andrew-abdelmalak/smart-cleaning-robot/docs/figures/chassis_cad.jpeg

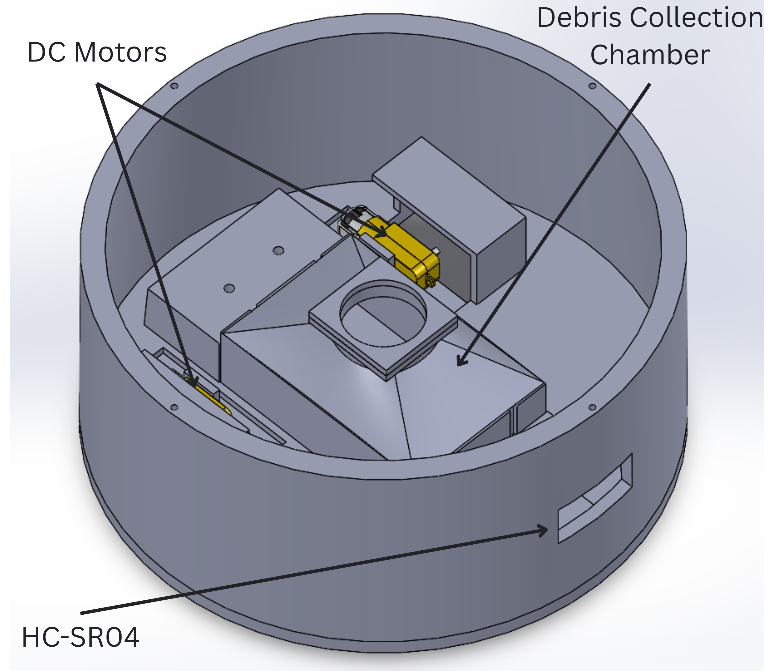
docs/figures/chassis_cad.jpeg
