andrew-abdelmalak/smart-cleaning-robot/docs/figures/figure_01.png

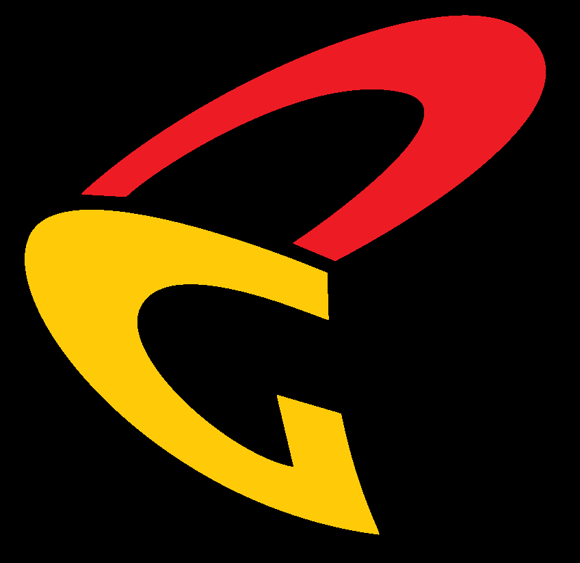
docs/figures/figure_01.png
