andrew-abdelmalak/smart-cleaning-robot/docs/figures/figure_02.jpeg

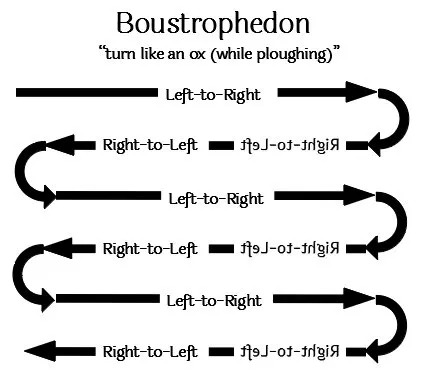
docs/figures/figure_02.jpeg
