andrew-abdelmalak/smart-cleaning-robot/docs/figures/figure_03.png

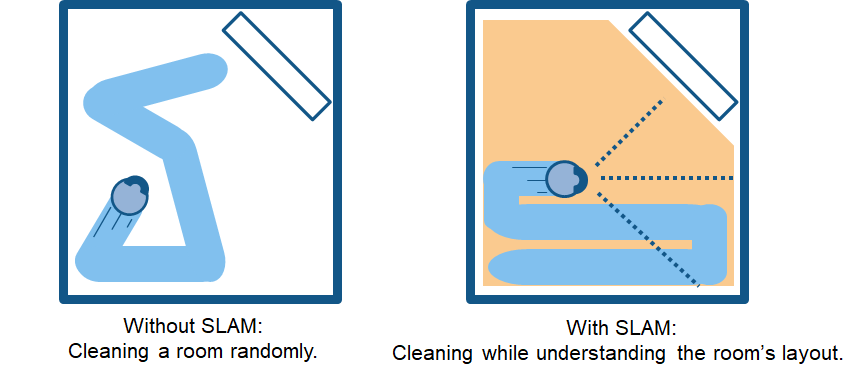
docs/figures/figure_03.png
