andrew-abdelmalak/smart-cleaning-robot/docs/figures/figure_04.jpeg

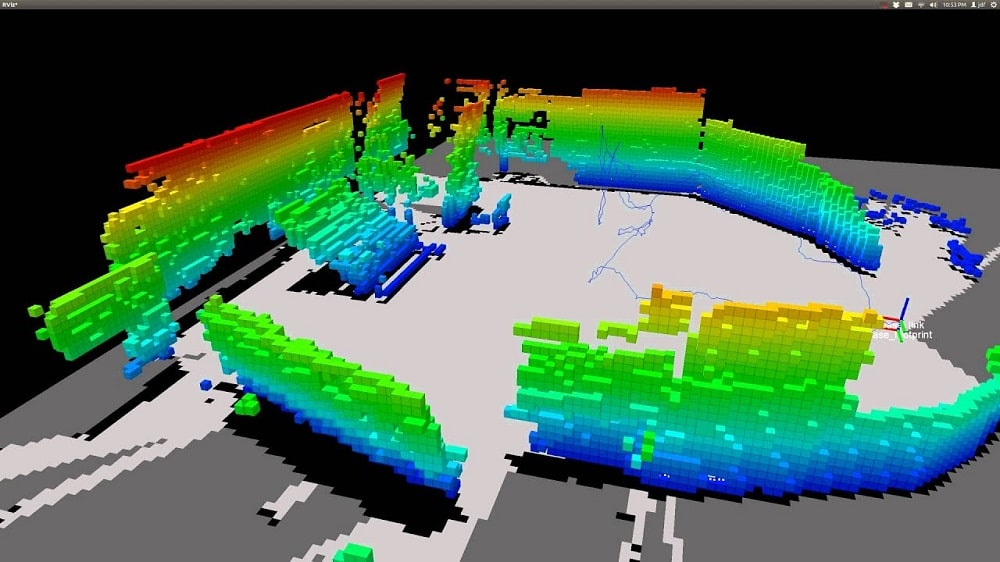
docs/figures/figure_04.jpeg
