andrew-abdelmalak/smart-cleaning-robot/docs/figures/figure_05.png

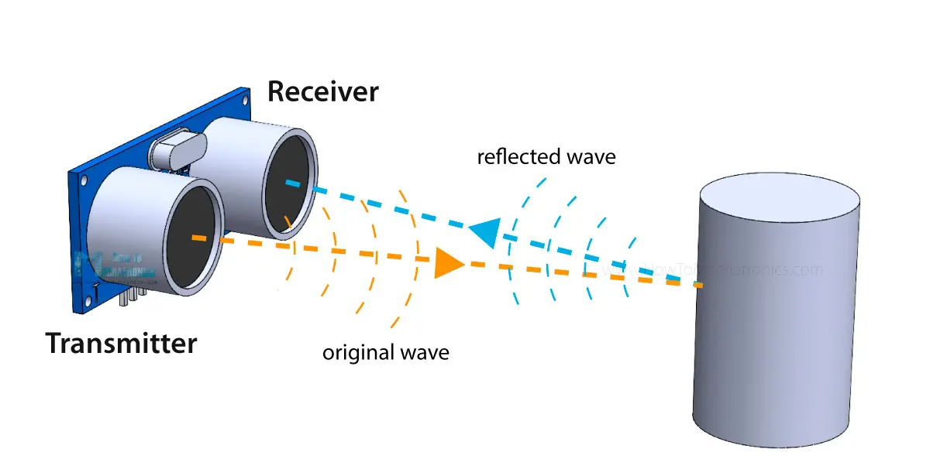
docs/figures/figure_05.png
