andrew-abdelmalak/smart-cleaning-robot/docs/figures/figure_07.jpeg

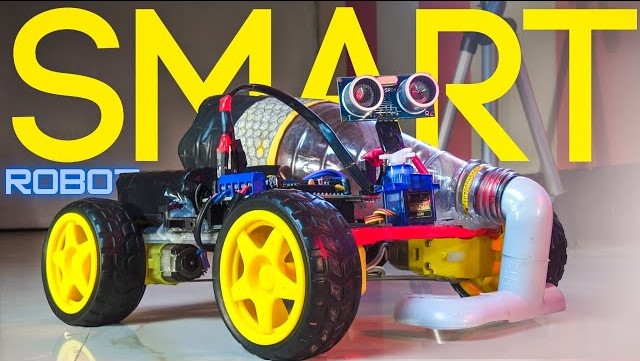
docs/figures/figure_07.jpeg
