andrew-abdelmalak/smart-cleaning-robot/docs/figures/figure_14.jpeg

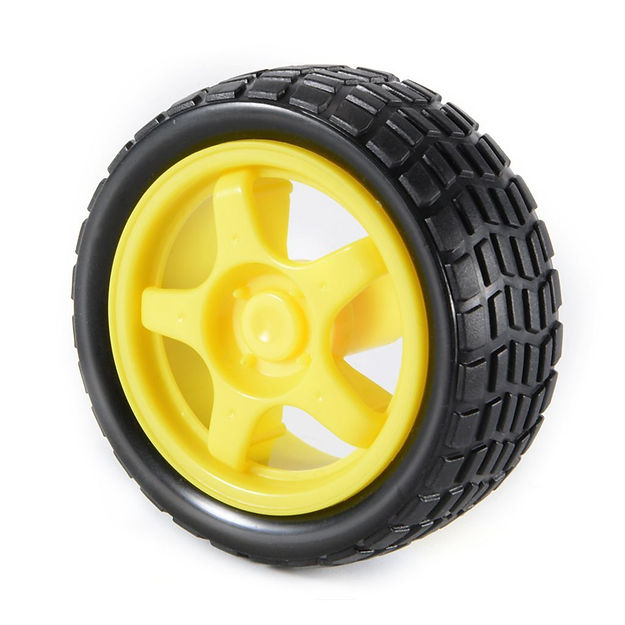
docs/figures/figure_14.jpeg
