andrew-abdelmalak/smart-cleaning-robot/docs/figures/figure_15.jpeg

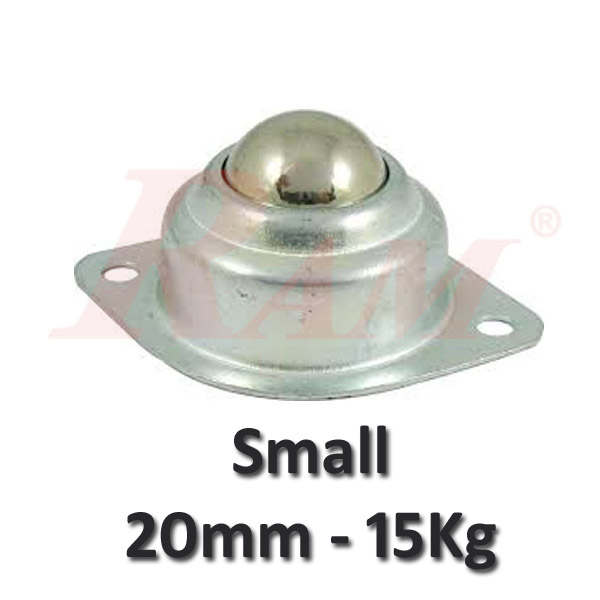
docs/figures/figure_15.jpeg
