andrew-abdelmalak/smart-cleaning-robot/docs/figures/figure_16.jpeg

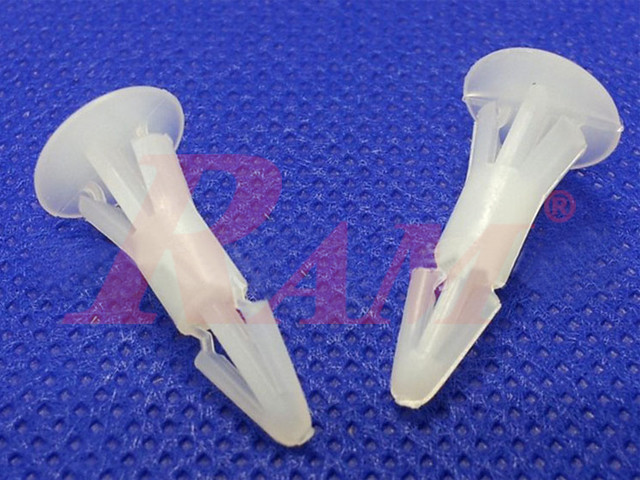
docs/figures/figure_16.jpeg
