andrew-abdelmalak/smart-cleaning-robot/docs/figures/figure_17.jpeg

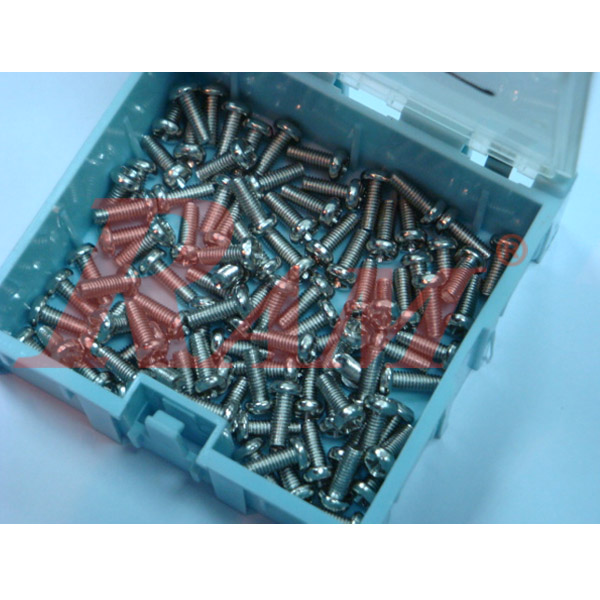
docs/figures/figure_17.jpeg
