andrew-abdelmalak/smart-cleaning-robot/docs/figures/figure_19.jpeg

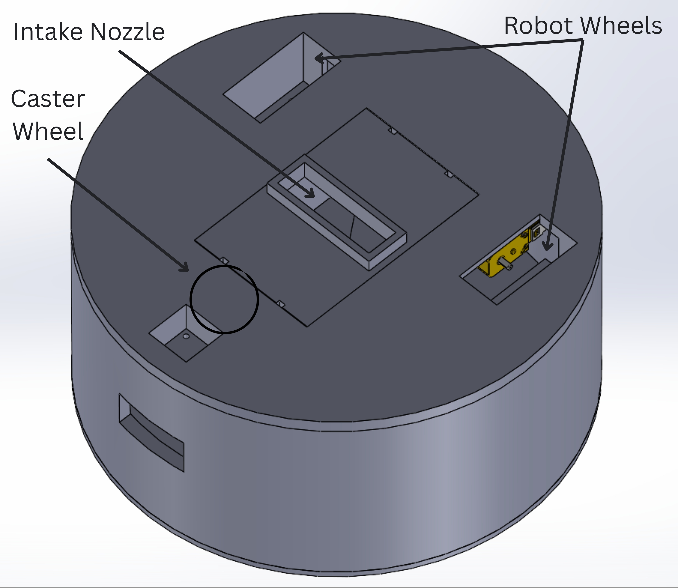
docs/figures/figure_19.jpeg
