andrew-abdelmalak/smart-cleaning-robot/docs/figures/figure_20.png

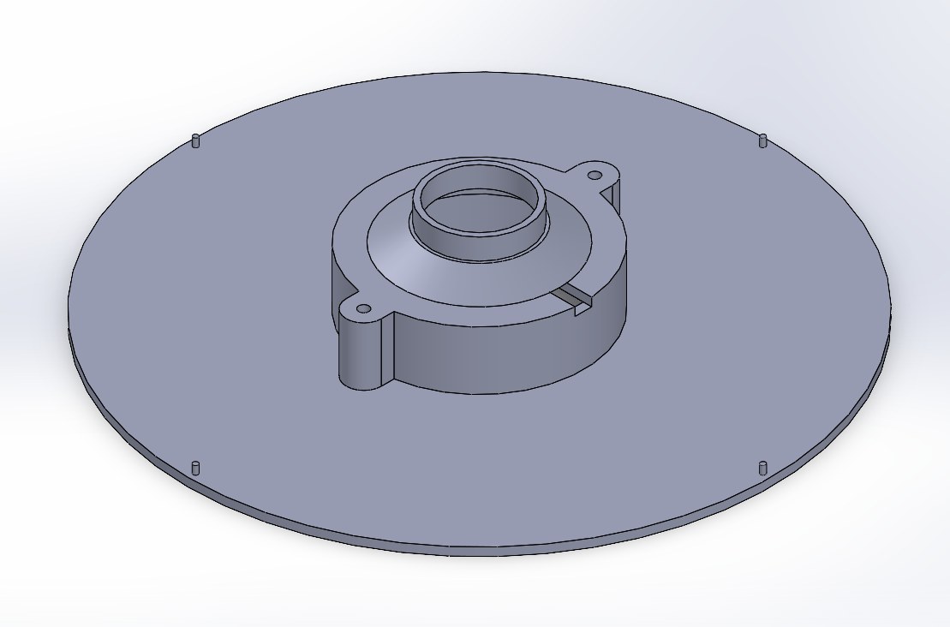
docs/figures/figure_20.png
