andrew-abdelmalak/smart-cleaning-robot/docs/figures/figure_25.jpeg

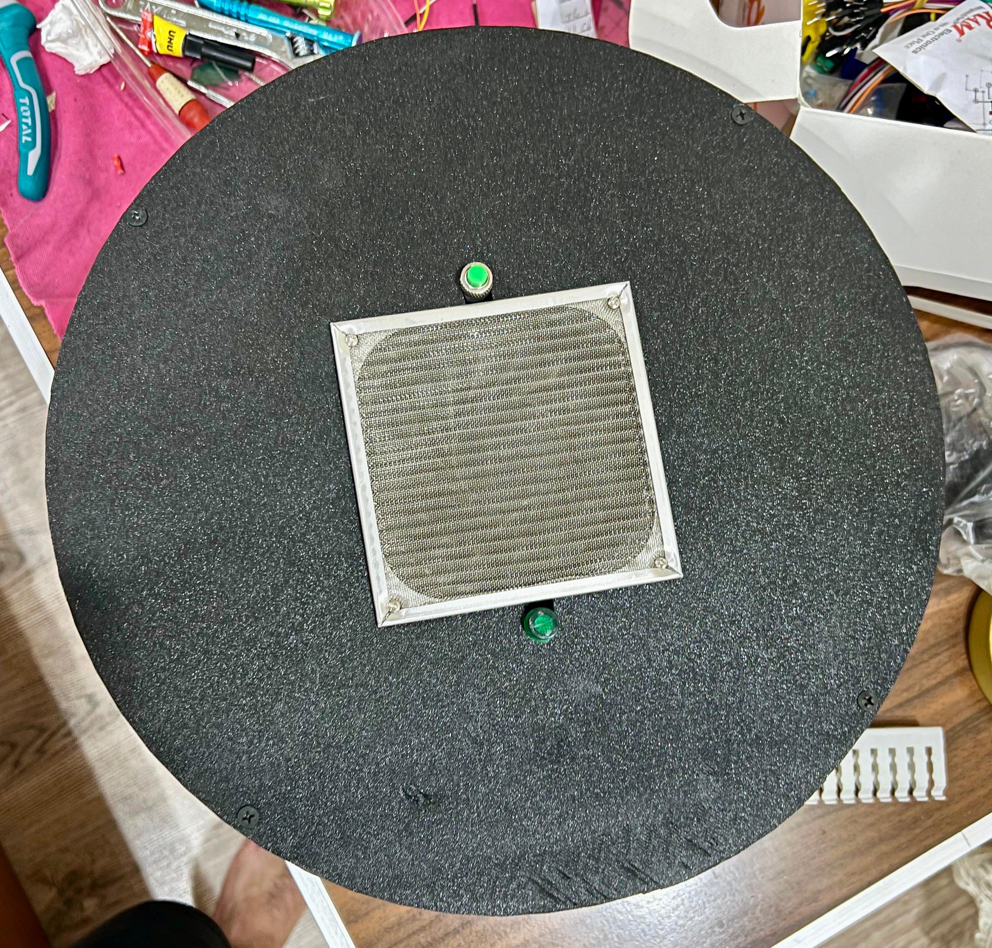
docs/figures/figure_25.jpeg
