andrew-abdelmalak/smart-cleaning-robot/docs/figures/figure_27.jpeg

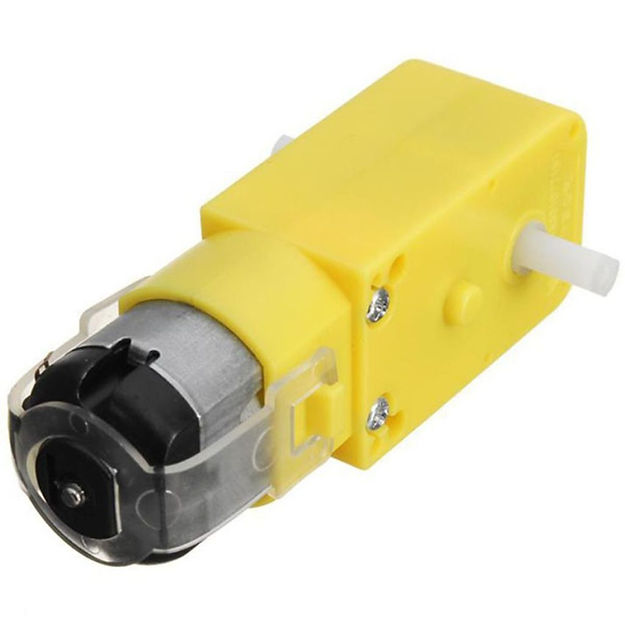
docs/figures/figure_27.jpeg
