andrew-abdelmalak/smart-cleaning-robot/docs/figures/figure_28.jpeg

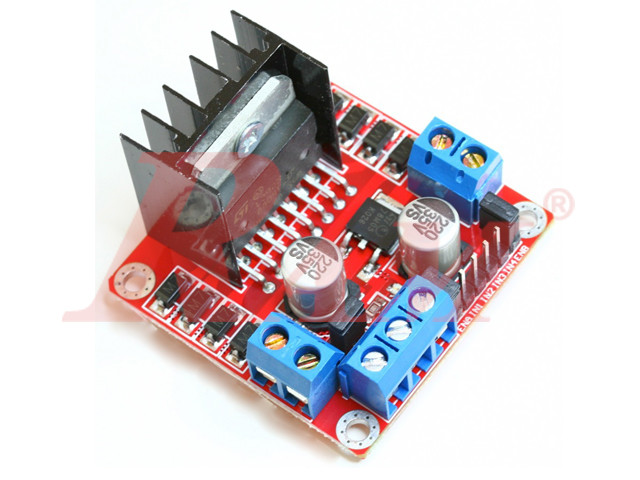
docs/figures/figure_28.jpeg
