andrew-abdelmalak/smart-cleaning-robot/docs/figures/figure_29.jpeg

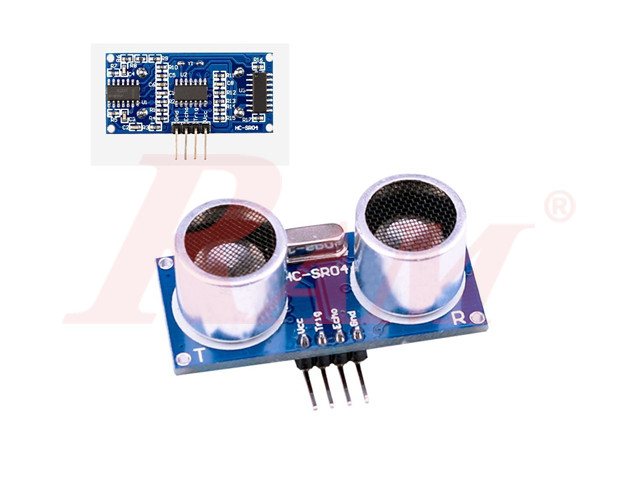
docs/figures/figure_29.jpeg
