andrew-abdelmalak/smart-cleaning-robot/docs/figures/figure_33.jpeg

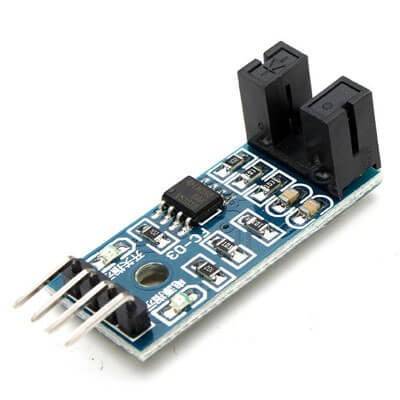
docs/figures/figure_33.jpeg
