andrew-abdelmalak/smart-cleaning-robot/docs/figures/figure_34.jpeg

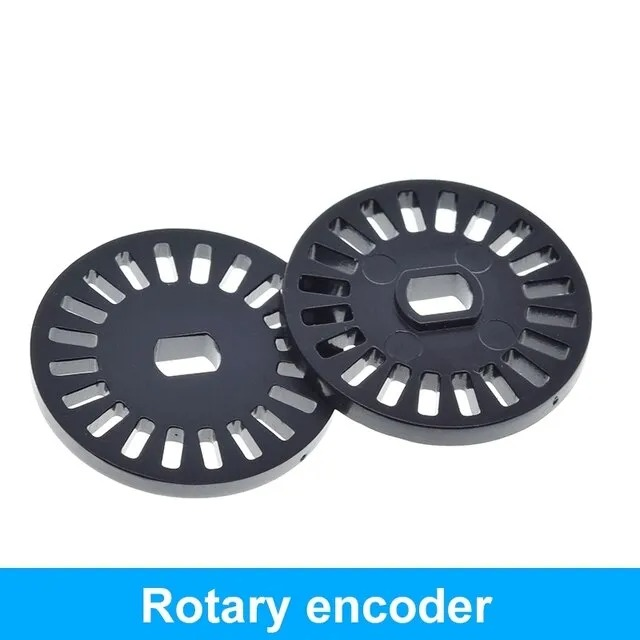
docs/figures/figure_34.jpeg
