andrew-abdelmalak/smart-cleaning-robot/docs/figures/figure_35.jpeg

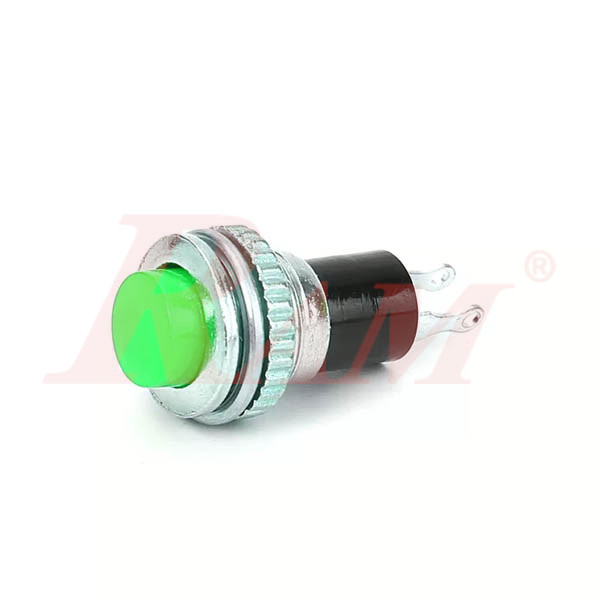
docs/figures/figure_35.jpeg
