andrew-abdelmalak/smart-cleaning-robot/docs/figures/figure_38.jpeg

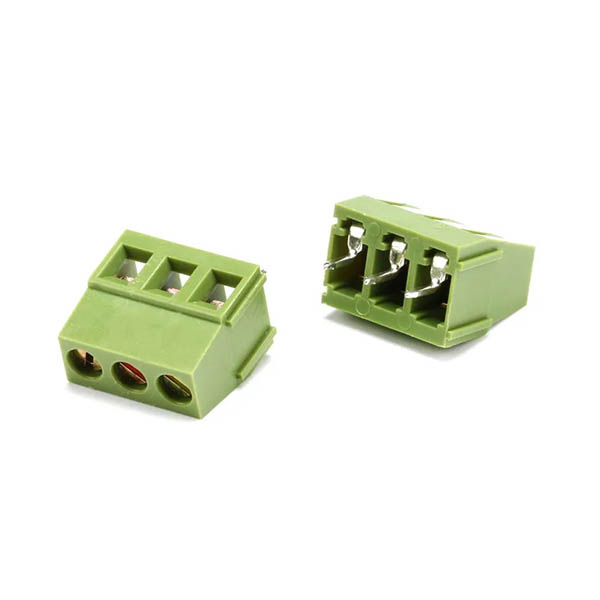
docs/figures/figure_38.jpeg
