andrew-abdelmalak/smart-cleaning-robot/docs/figures/figure_40.jpeg

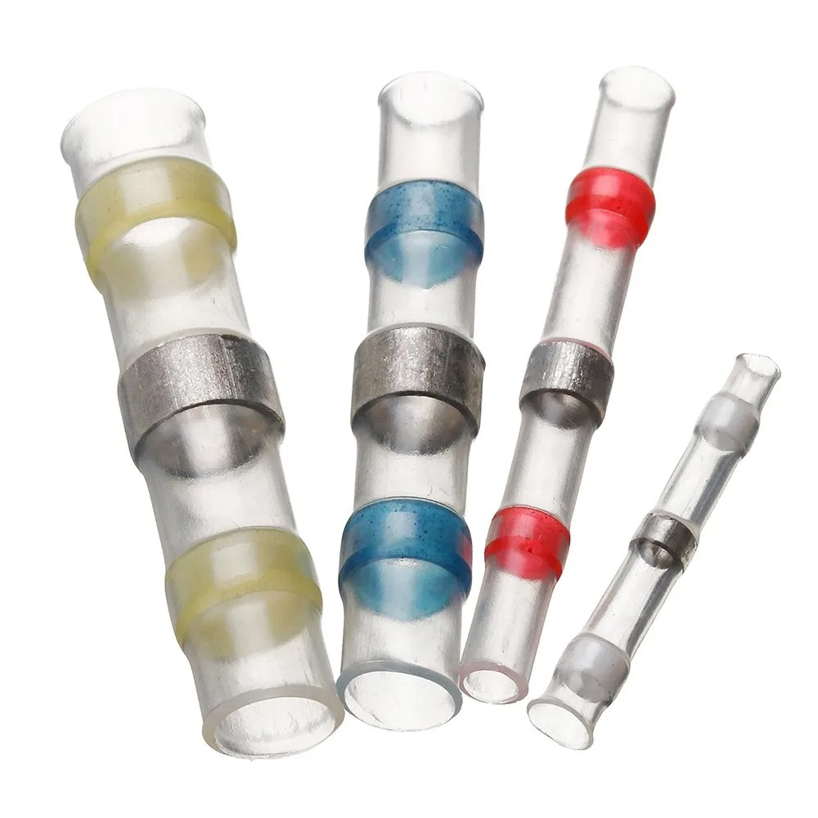
docs/figures/figure_40.jpeg
