andrew-abdelmalak/smart-cleaning-robot/docs/figures/figure_41.png

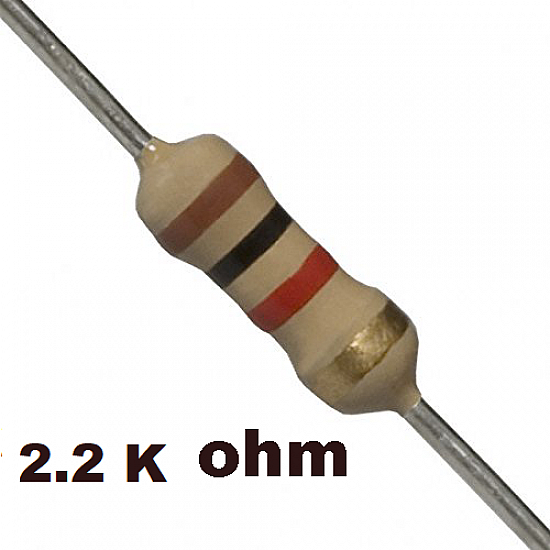
docs/figures/figure_41.png
