andrew-abdelmalak/smart-cleaning-robot/docs/figures/figure_43.jpeg

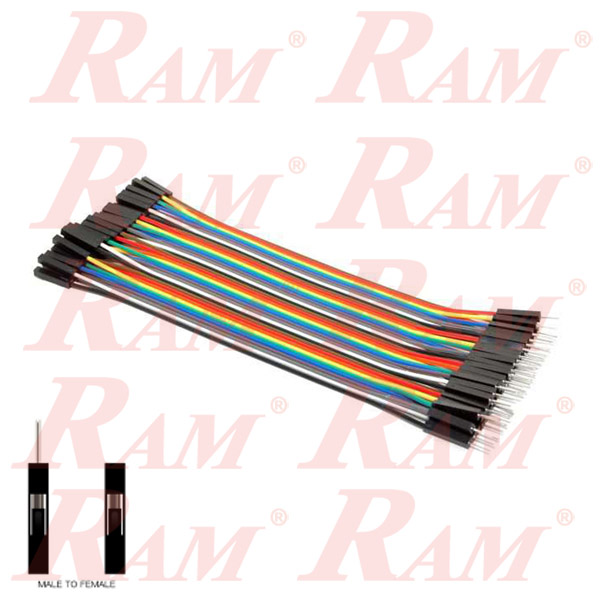
docs/figures/figure_43.jpeg
