andrew-abdelmalak/smart-cleaning-robot/docs/figures/figure_44.jpeg

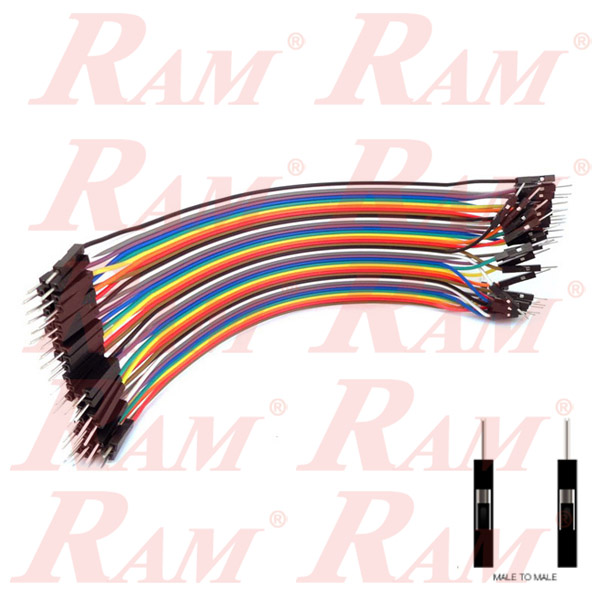
docs/figures/figure_44.jpeg
