andrew-abdelmalak/smart-cleaning-robot/docs/figures/figure_46.jpeg

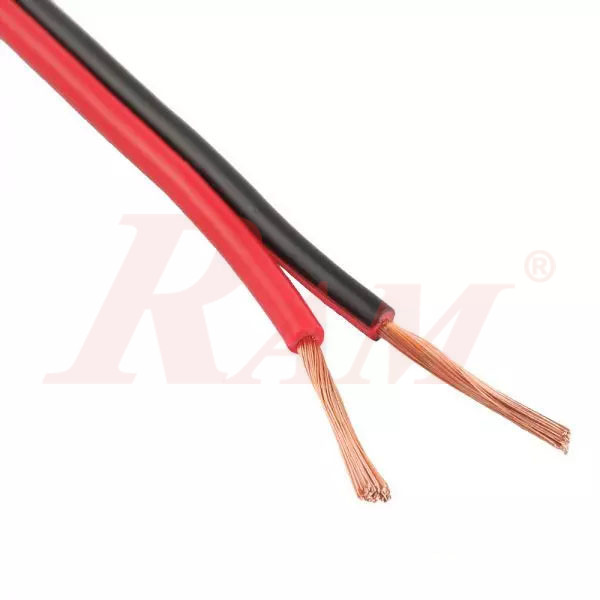
docs/figures/figure_46.jpeg
