andrew-abdelmalak/smart-cleaning-robot/docs/figures/figure_48.png

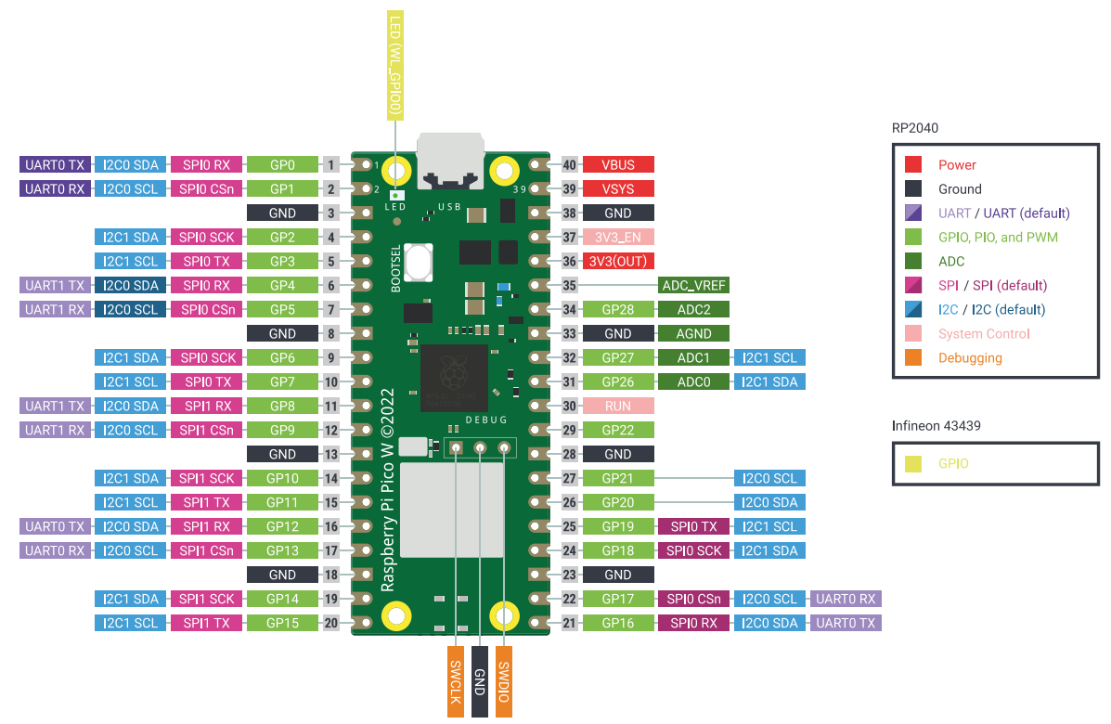
docs/figures/figure_48.png
