andrew-abdelmalak/smart-cleaning-robot/docs/figures/figure_49.jpeg

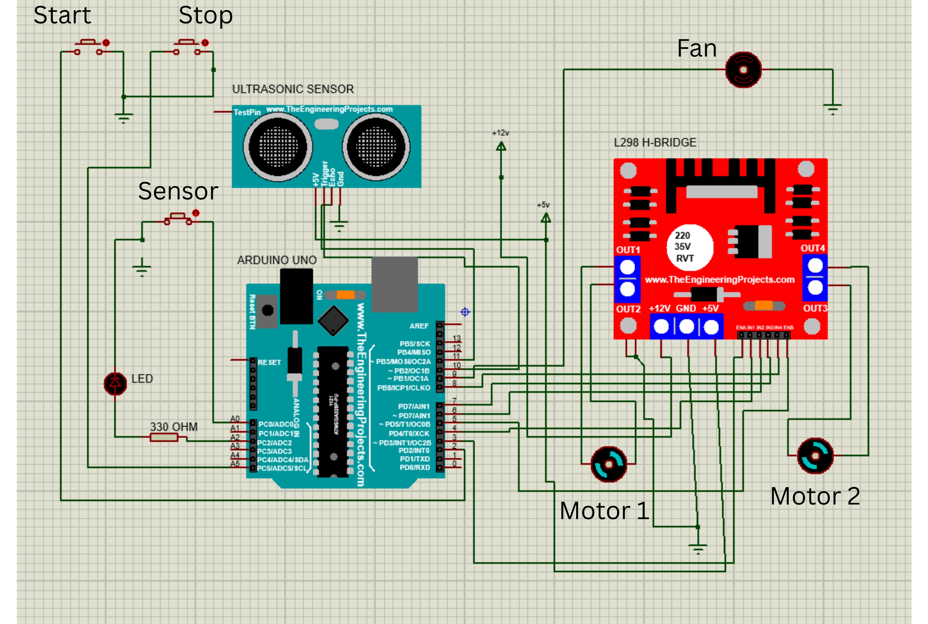
docs/figures/figure_49.jpeg
