andrew-abdelmalak/smart-cleaning-robot/docs/figures/figure_50.jpeg

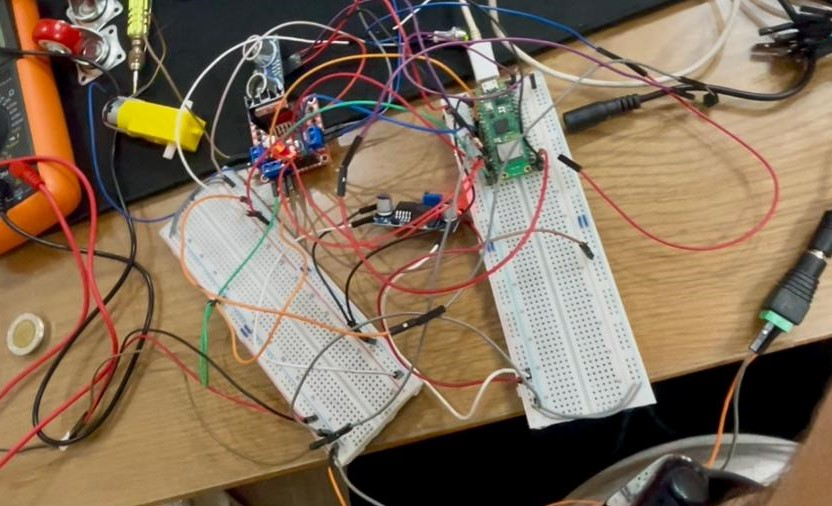
docs/figures/figure_50.jpeg
