andrew-abdelmalak/smart-cleaning-robot/docs/figures/figure_52.png

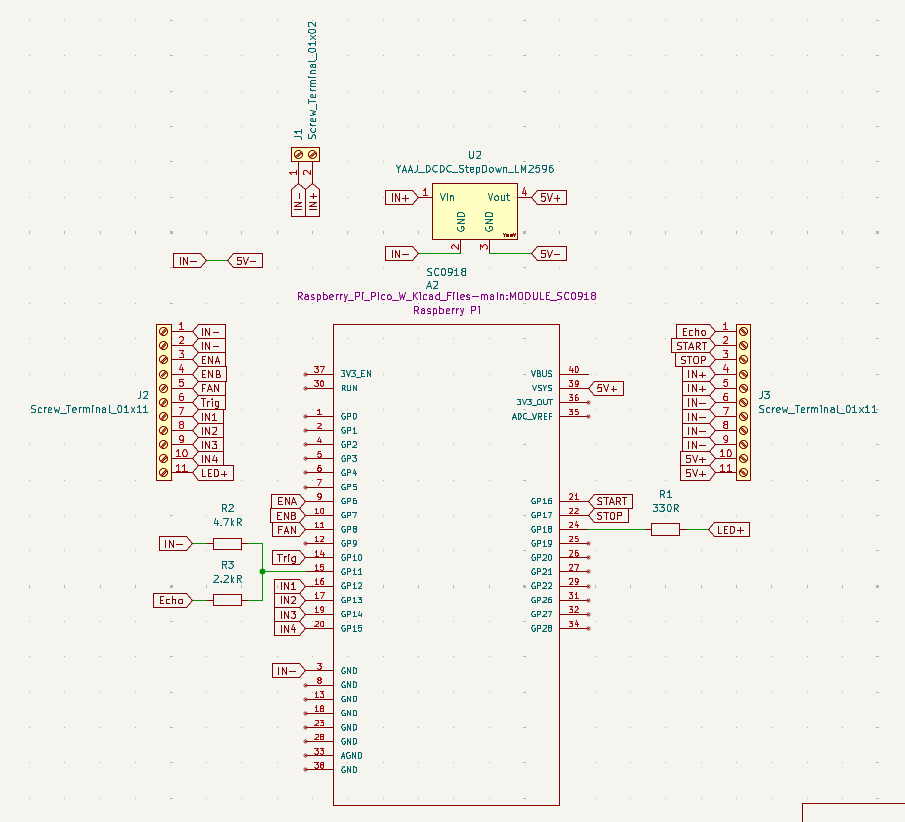
docs/figures/figure_52.png
