andrew-abdelmalak/smart-cleaning-robot/docs/figures/figure_53.png

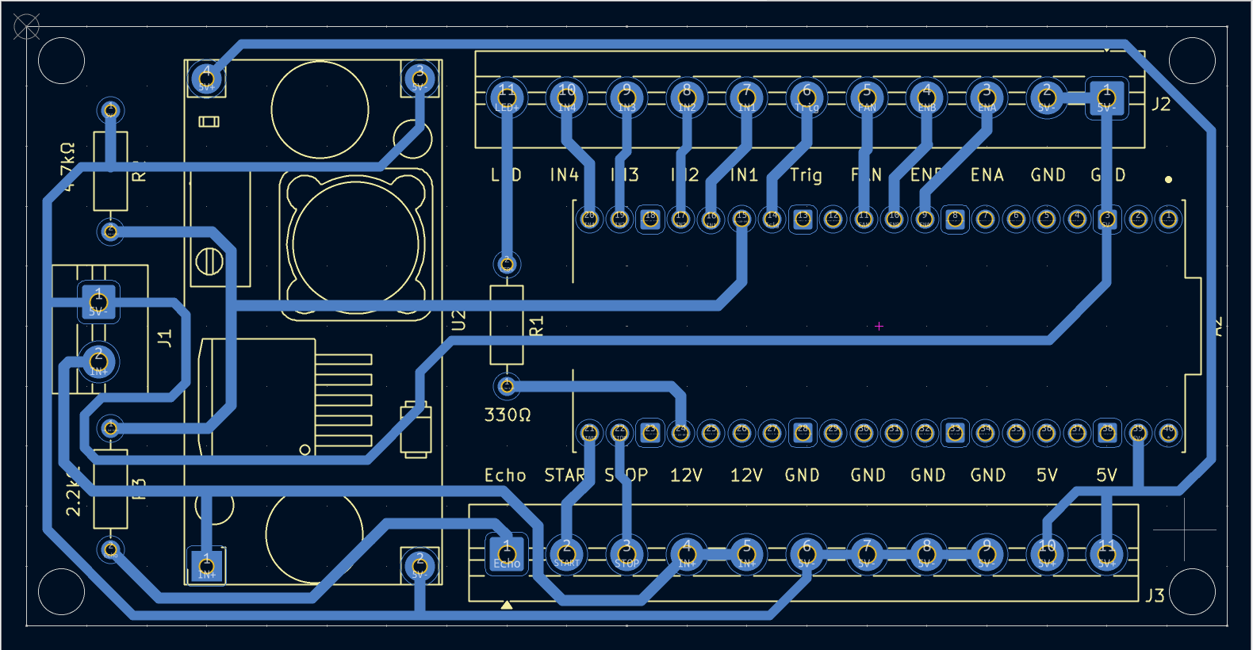
docs/figures/figure_53.png
