andrew-abdelmalak/smart-cleaning-robot/docs/media/brag-poster.jpg

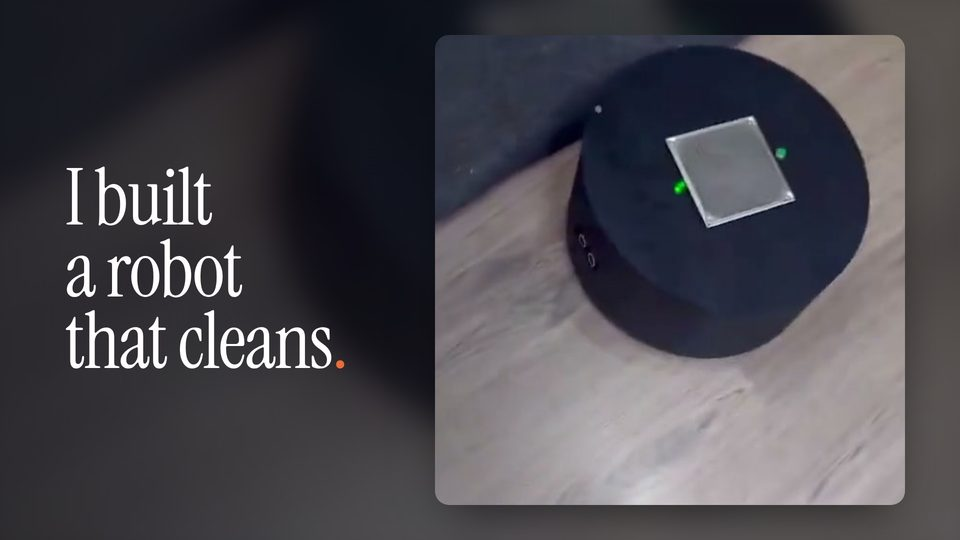
docs/media/brag-poster.jpg
