andrew-abdelmalak/smart-cleaning-robot/hardware/drawings/drawings.webp

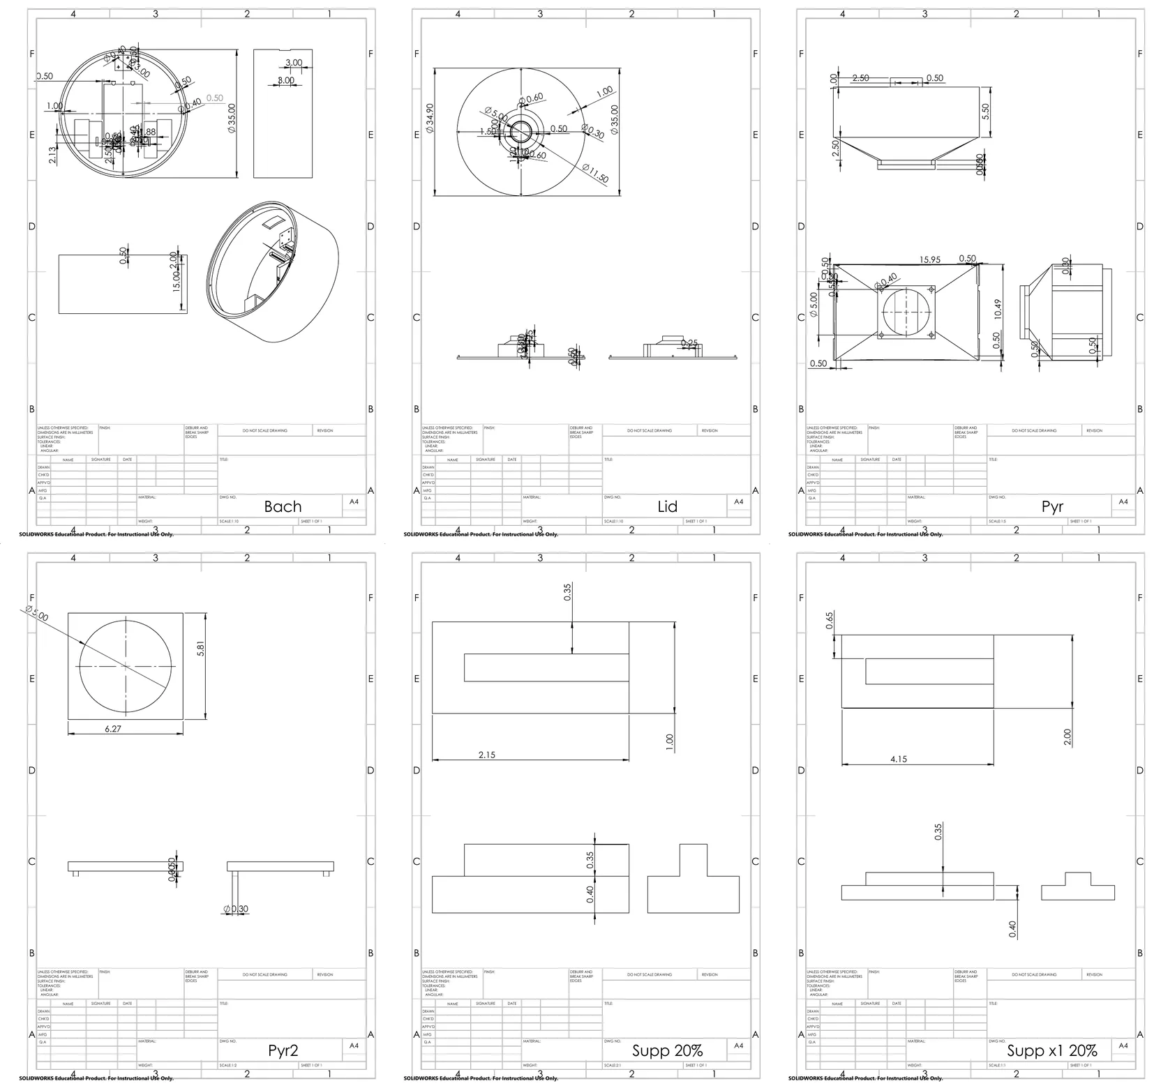
hardware/drawings/drawings.webp
