andrew-abdelmalak/smart-cleaning-robot/site/img/phone-control-poster.webp

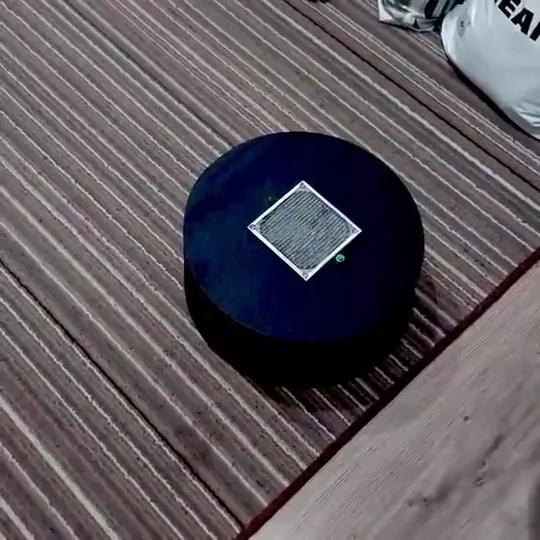
site/img/phone-control-poster.webp
