andrew-abdelmalak/smart-cleaning-robot/site/img/robot-driving-poster.webp

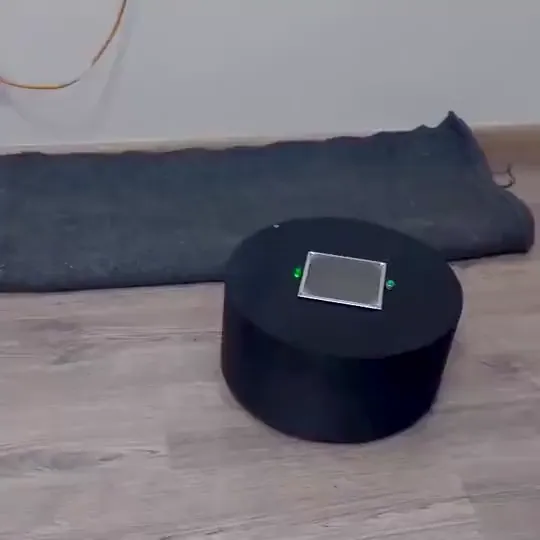
site/img/robot-driving-poster.webp
