andrew-abdelmalak/smart-cleaning-robot/site/img/robot-iso.webp

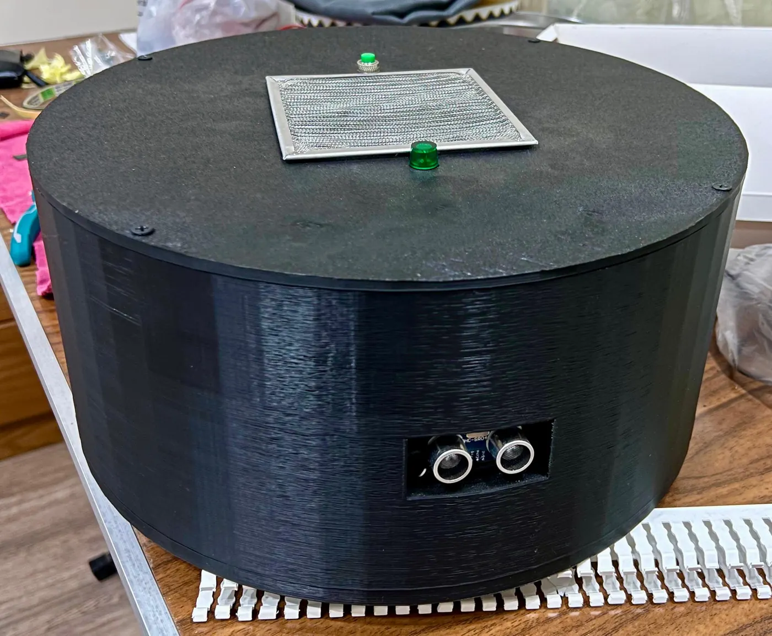
site/img/robot-iso.webp
