andrew-abdelmalak/smart-cleaning-robot/docs/thesis/images/components/battery_12v.jpg

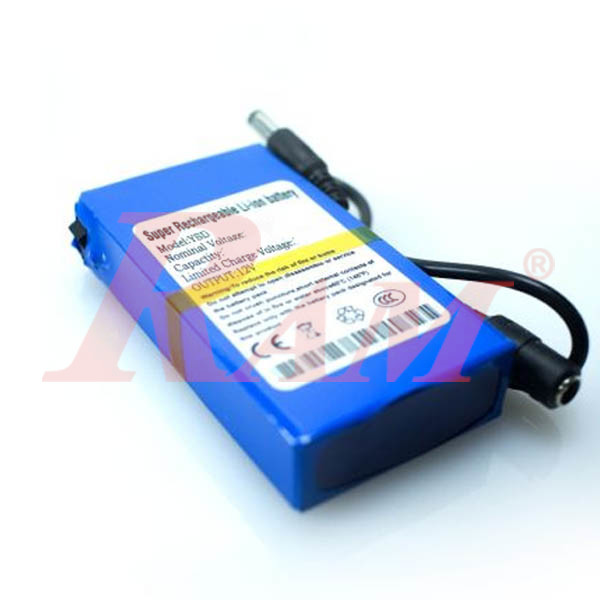
docs/thesis/images/components/battery_12v.jpg
