andrew-abdelmalak/smart-cleaning-robot/docs/thesis/images/components/jumper_ff.jpg

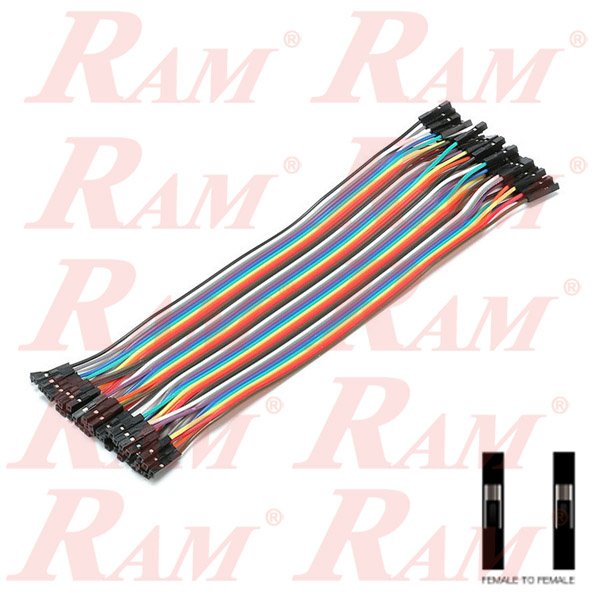
docs/thesis/images/components/jumper_ff.jpg
