andrew-abdelmalak/smart-cleaning-robot/docs/thesis/images/components/led_indicator.jpg

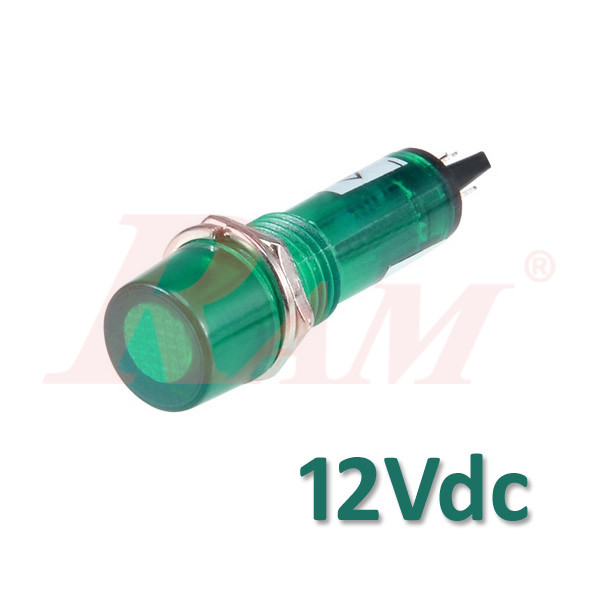
docs/thesis/images/components/led_indicator.jpg
