andrew-abdelmalak/smart-cleaning-robot/docs/thesis/images/components/lm2596s_buck.jpg

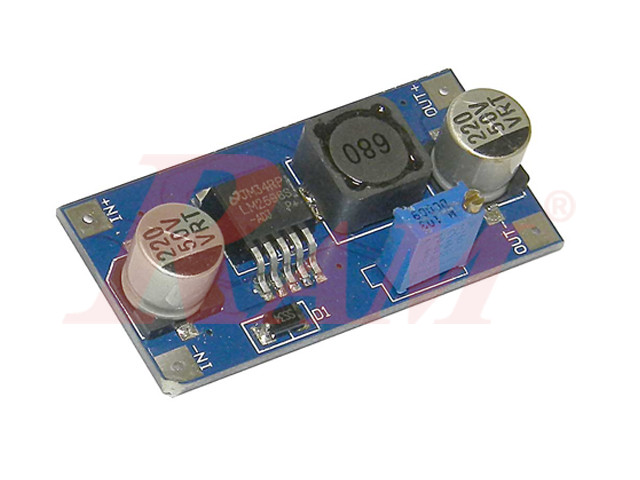
docs/thesis/images/components/lm2596s_buck.jpg
