andrew-abdelmalak/smart-cleaning-robot/docs/thesis/images/components/pico_w.jpg

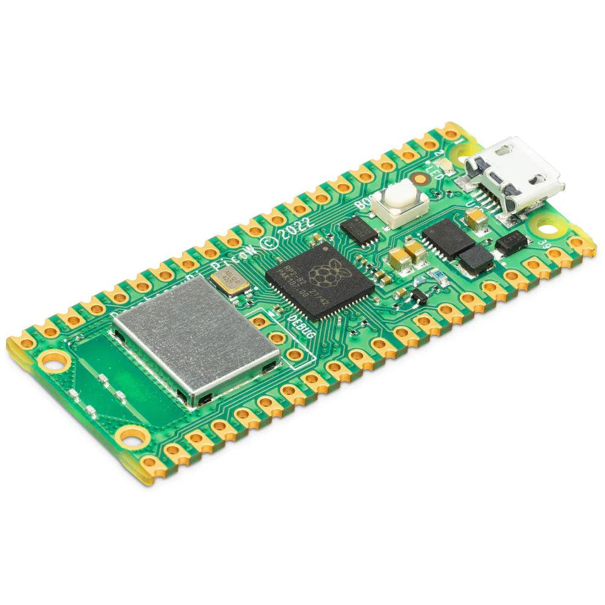
docs/thesis/images/components/pico_w.jpg
