andrew-abdelmalak/smart-cleaning-robot/docs/thesis/images/components/pin_header_female.jpg

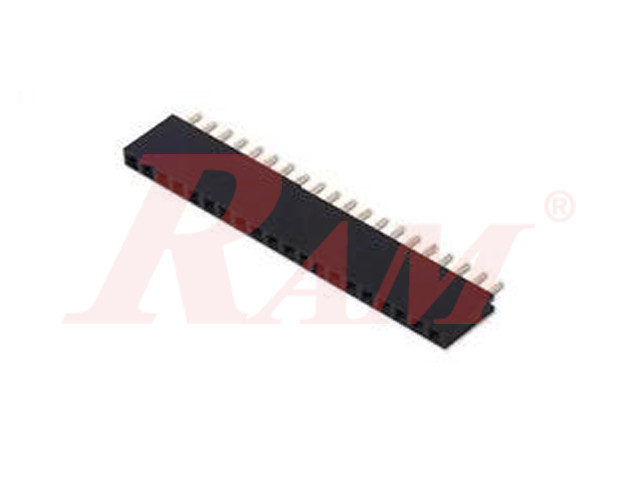
docs/thesis/images/components/pin_header_female.jpg
