andrew-abdelmalak/smart-cleaning-robot/docs/thesis/images/components/ps3_fan.jpg

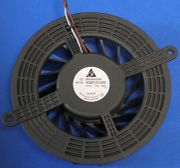
docs/thesis/images/components/ps3_fan.jpg
