andrew-abdelmalak/smart-cleaning-robot/docs/thesis/images/components/resistor_4k7.jpg

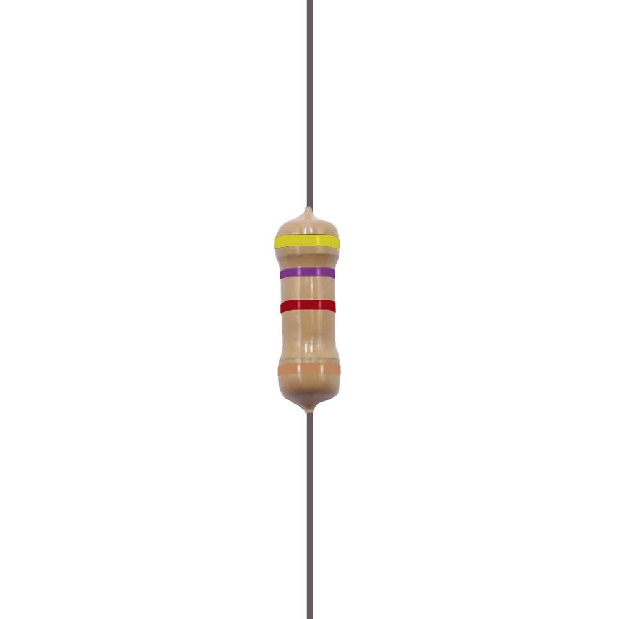
docs/thesis/images/components/resistor_4k7.jpg
