andrew-abdelmalak/smart-cleaning-robot/hardware/cad/chassis.SLDPRT

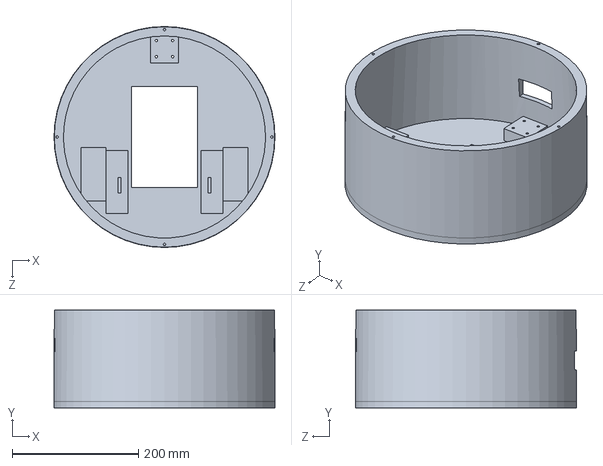
[picture p70: CAD file, 2026-10-25]
hardware/cad/chassis.SLDPRT
350.0 x 155.0 x 350.0 mm
