andrew-abdelmalak/smart-cleaning-robot/hardware/cad/mount-1.SLDPRT

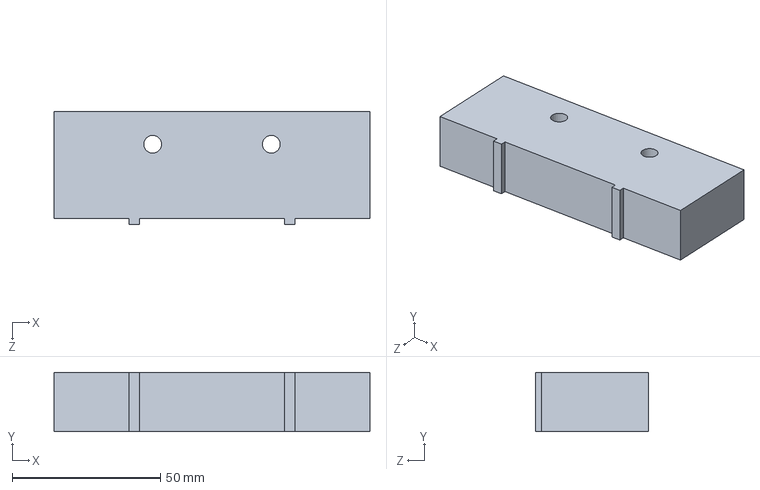
[picture p71: CAD file, 2026-10-25]
hardware/cad/mount-1.SLDPRT
106.5 x 20.0 x 38.0 mm
