andrew-abdelmalak/smart-cleaning-robot/hardware/cad/mount-2.SLDPRT

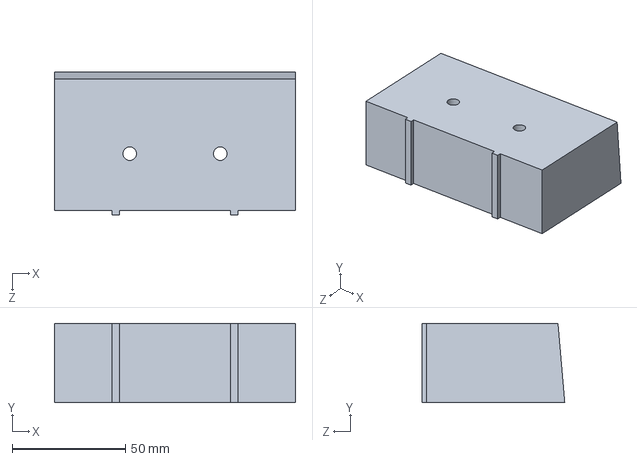
[picture p72: CAD file, 2026-10-25]
hardware/cad/mount-2.SLDPRT
106.5 x 35.0 x 63.0 mm
