andrew-abdelmalak/smart-cleaning-robot/docs/thesis/images/cad/chassis_assembled_isometric.jpg

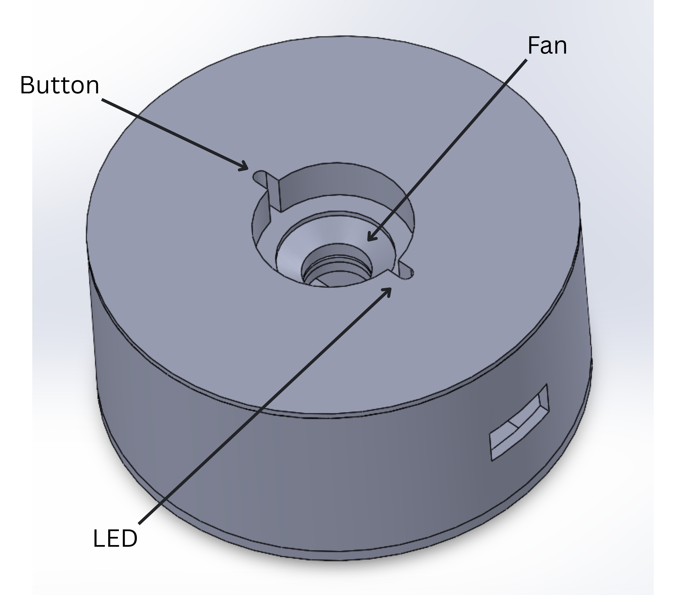
docs/thesis/images/cad/chassis_assembled_isometric.jpg
