andrew-abdelmalak/smart-cleaning-robot/hardware/pcb/smart-cleaning-robot.kicad_pcb

## KiCad design hardware/pcb/smart-cleaning-robot.kicad_pcb (2026-10-25)

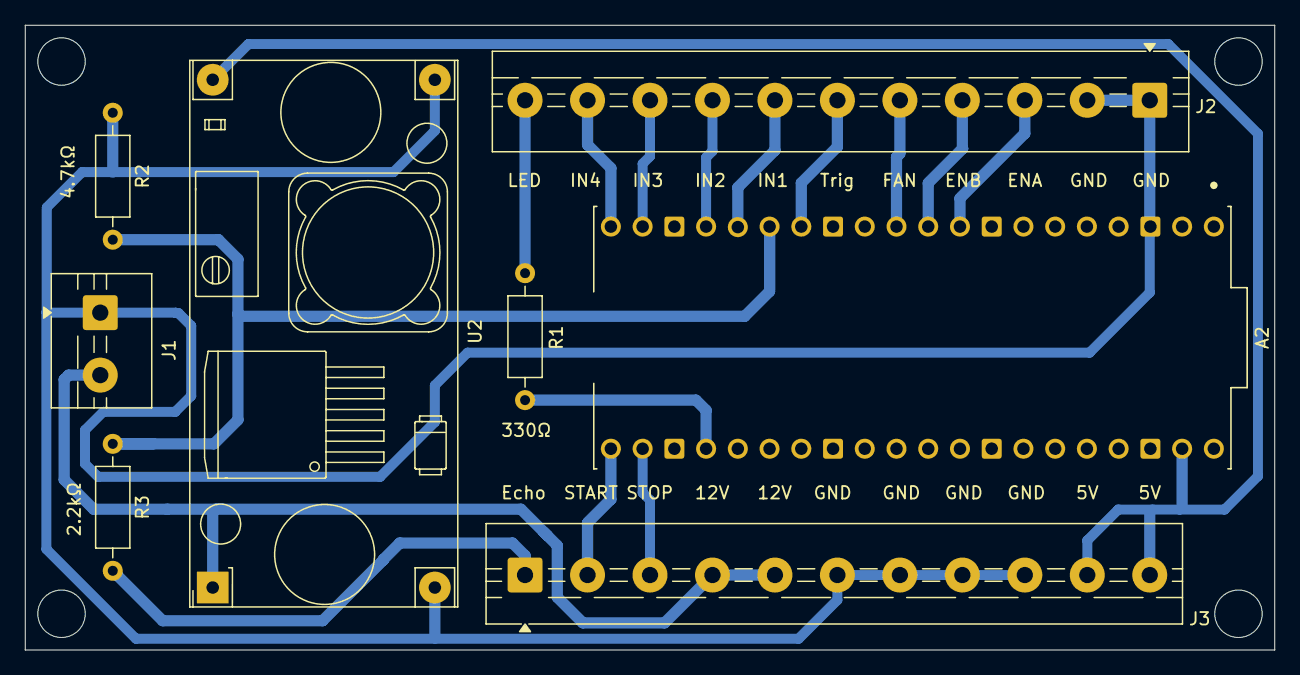
[picture p79: board smart-cleaning-robot.kicad_pcb from above]

Board: 2 copper layers, 100.0 x 50.0 mm, 8 parts (0 on the bottom side), 17 nets.

Parts:
A2: SC0918; MODULE_SC0918
J1: Screw_Terminal_01x02; TerminalBlock_MaiXu_MX126-5.0-02P_1x02_P5.00mm
J2, J3: Screw_Terminal_01x11; TerminalBlock_MaiXu_MX126-5.0-11P_1x11_P5.00mm
R1: 330R; R_Axial_DIN0207_L6.3mm_D2.5mm_P10.16mm_Horizontal
R2: 4.7kR; R_Axial_DIN0207_L6.3mm_D2.5mm_P10.16mm_Horizontal
R3: 2.2kR; R_Axial_DIN0207_L6.3mm_D2.5mm_P10.16mm_Horizontal
U2: YAAJ_DCDC_StepDown_LM2596

Connections:
5V+: A2.39 (VSYS), J3.10, J3.11, U2.4 (Vout)
5V-: A2.3 (GND), J1.1, J2.1, J2.2, J3.6, J3.7, J3.8, J3.9, R2.1, U2.2 (GND), U2.3 (GND)
ENA: A2.9 (GP6), J2.3
ENB: A2.10 (GP7), J2.4
Echo: J3.1, R3.2
FAN: A2.11 (GP8), J2.5
IN1: A2.16 (GP12), J2.7
IN2: A2.17 (GP13), J2.8
IN3: A2.19 (GP14), J2.9
IN4: A2.20 (GP15), J2.10
IN+: J1.2, J3.4, J3.5, U2.1 (Vin)
LED+: J2.11, R1.2
unnamed: A2.15 (GP11), R2.2, R3.1
unnamed: A2.24 (GP18), R1.1
START: A2.21 (GP16), J3.2
STOP: A2.22 (GP17), J3.3
Trig: A2.14 (GP10), J2.6
