andrew-abdelmalak/smart-cleaning-robot/(commit log)

2026-03-19 Polish repo for publication
    - Overhaul README with full thesis data: overview table, hardware
    specifications, pin-mapping, BLE command reference (GATT UUIDs +
    command table), key-results table, cost-comparison table (60-90 %
    cheaper than commercial platforms), autonomous FSM state table,
    PID/feed-forward control-design section, author + supervisors table,
    acknowledgments, and thesis citation
    - Extract 57 figures from thesis PDF into docs/figures/; add 7
    descriptive aliases (assembled_robot, chassis_cad, control_flowchart,
    state_machine, ble_controller, assembled_robot_bottom,
    assembled_robot_internal)
    - Add GitHub Actions CI: .github/workflows/lint.yml using
    astral-sh/ruff-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
2026-03-19 Fix Phase 2 audit: add References section, standardize .gitignore headers
    - README.md: add ## References section (6 citations: Choset coverage
    robotics, Cadena SLAM, Durrant-Whyte SLAM, Raspberry Pi Pico W
    datasheet, L298N datasheet, HC-SR04 datasheet) — inserted before
    ## License to complete the standard section sequence
    - .gitignore: convert section headers from # ── format to
    # ======================== standard used across all other repositories;
    rename "OS" to "OS Generated Files", "Logs" to "Logs & Temporary"
2026-10-19 Fix HORN command so a second HORN switches the horn off
    horn_buzz() drives the motors at 10 % duty, so is_full_stop() is false
    while the horn sounds and the second HORN was ignored. Only switching the
    horn on now requires a full stop.
2026-10-19 Split the control loop into command, manual, and autonomous steps
    control_step() holds one loop iteration. handle_command(), drive_manual(),
    and run_autonomous_step() return True where the old loop used continue.
    AVOID and STALL_TURN share one branch, start_pivot() replaces two copies
    of the pivot reset, and dead pivot resets on manual turns are removed.
2026-10-19 Add type hints, docstrings, and narrower exception handling to firmware
    Sort imports, rename pivot_start_L/R and the dir parameter, drop unused
    global declarations, merge the two LED flash branches, log advertising
    failures instead of passing silently, and catch only UnicodeError when
    decoding BLE writes.
2026-10-19 Clear the obstacle block in emergency_stop
    After an emergency stop during an obstacle block, forward_blocked stayed
    set, so the loop kept buzzing the motors at 10 % and refused CLEAN, FAN,
    and HORN until a move-away command arrived.
2026-10-19 Let HORN and FORWARD silence the horn during an obstacle block
    The loop buzzed while horn_active or forward_blocked was set, so the
    existing silence branches cleared horn_active with no effect. Only
    horn_active drives the buzzer now; forward_blocked still blocks FORWARD
    and keeps the LED flashing rapidly.
2026-10-19 Simplify firmware: shared PID and feed-forward helpers, one reset path
    _pid() replaces three copies of the clamped PID update and _drive_pps()
    four copies of the feed-forward conversion. emergency_stop() reuses
    stop_all_movement(), start_straight(), and start_pivot(). The
    emergency_active flag is removed: it was set and cleared inside one call,
    so the loop could never see it. Behavior is unchanged; tests pass.
2026-10-20 Add a project site that runs the real firmware in the browser
    The site (site/) is a single static page for recruiters and engineers:
    the real demo clips, the build from breadboard to finished robot, the
    thesis results and limits, and the diagrams.
    Its remote drives firmware/main.py, unchanged, in MicroPython compiled
    to WebAssembly. site/bench.py fakes the hardware as tests/conftest.py
    does, with the robot on a simulated test stand; tests/test_bench.py
    checks the stand under CPython. A Pages workflow assembles and deploys
    the site.
2026-10-20 Apply design review fixes to the project site
    Shows the simulated-stand label on phones, dims keys the firmware would
    ignore, keeps the stand controls next to the stand, tightens line
    lengths and captions, and records each image's origin in its metadata.
    Removes an unused image.
2026-10-20 Bring back the drawn room, driven by the real firmware
    The remote now drives the robot through a hand-drawn room again, but
    the robot runs firmware/main.py unchanged: the room only supplies what
    the ultrasonic sensor sees and when the wheels push against furniture.
    Wheel speed is the firmware's motor model slowed to the pace of the real
    driving clip. The simulated clock now keeps pace with real time, and a
    paused animation can no longer leave a second loop running.
2026-10-20 Polish the drawn room and add the thesis-search tools
    The room is smaller so the robot reads larger, shows the vacuumed floor
    as light stripes and a floor-cleaned score, and captions moments such as
    an obstacle turn or a stuck wheel in plain words.
    Adds a search dependency group (onnxruntime, tokenizers) for building
    the thesis search index offline, and pins the resolver cutoff in
    pyproject.toml so the lockfile stays reproducible.
2026-10-20 Add "Ask the thesis", semantic search over the thesis
    The thesis section of the site gets a search box. A question is embedded
    in the browser with all-MiniLM-L6-v2 (transformers.js 4.3.0, pinned model
    revision) and matched against 141 passages cut from the thesis PDF, each
    tagged with its section and page. Results quote the passage and open the
    PDF at that page. Keyword matches show at once and while the model loads,
    and stay as the fallback if it fails to load.
    scripts/build_thesis_index.py builds site/thesis-index.json offline with
    the same model, so browser and build agree. Passage vectors lean toward
    their section titles, and ranking adds a share of BM25 keyword score; on
    21 sample ques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
2026-10-20 Fix review findings on the site, the bench, and the index build
    Code, security, and accessibility reviews of the code added after the
    firmware work.
    Site:
    - The room keeps running while only the remote is on screen, so keys
    work on a phone with the room scrolled away.
    - In the simulation the wheels now also turn while the firmware waits for
    the sonar echo. Speed no longer drops by up to half on open floor;
    FLOOR_LOAD goes from 0.35 to 0.27 to keep the same pace at 1 m.
    - A held arrow key no longer toggles drive and brake.
    - "Ignored" notes appear only after the firmware has read the command.
    - The loop stops with a message on an error, and Reset room restarts it.
    - The pace no longer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
2026-10-21 Let Dependabot track the site's vendored browser libraries
    package.json now lists the transformers.js and MicroPython WebAssembly
    versions, which nothing installs; Dependabot's npm updater proposes new
    ones monthly after a 14-day cooldown. The ONNX runtime follows the
    version transformers.js depends on.
    fetch_vendor.py now takes each file from its npm package tarball, checked
    against the registry's integrity hash, and --update re-pins vendor.json
    from package.json. A new test fails when the two disagree, so a
    Dependabot bump cannot deploy until the pins are refreshed.
    The GitHub Actions cooldown goes from 7 to 14 days, matching the rest.
2026-10-21 Pin the transformers.js 4.3.1 file
    Re-pinned with scripts/fetch_vendor.py --update from the registry-verified
    npm tarball. The ONNX runtime it depends on is unchanged. Search checked
    in the browser under the site's Content Security Policy.
2026-10-21 Replace the drawn room with a tested living-room layout and add 4x speed
    The old room let the robot circle one strip and stall often (24 % of the
    floor after 2 minutes, 11 stalls). The new 4.8 m by 2.7 m living room
    (sofa, coffee table, armchair, plant) was chosen by running the real
    firmware in a Python copy of this simulation over about 4,000 realistic
    layouts, then ranking the best by their average over runs with slightly
    different start and frame timing, since a single run is chaotic. It
    cleans about 41 % in 2 minutes and 65 % in 5, sweeps 1.5 m2 per m2
    cleaned, and stalls about 3 times in 3 minutes.
    - The simulated HC-SR04 casts five rays across its 30-degree datasheet
    measuring angl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
2026-10-21 Release 1.2.0: new project video, autoplay, and focus-ring contrast
    - The 34-second project video is re-recorded with the new drawn room,
    shown at the labelled 4x speed: the camera follows the first obstacle
    stop, then the remote's Stop cleaning and Honk presses, on the same
    music and timing as before.
    - On the site the video now plays muted and looping when it scrolls into
    view, like the other clips; its controls turn the sound on.
    - The README shows a silent animated WebP preview (autoplays on GitHub)
    that links to the version with sound; the unused poster JPEG is gone.
    - Focus rings had under 3:1 contrast (WCAG 1.4.11). They use a deeper
    tangerine on light surfaces and ember i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
2026-10-21 Show the robot during the honk in the project video
    The camera stayed on the remote after the Honk press, so the honk itself
    was off screen. It now pans from the remote up to the robot and the
    "Honk!" caption while the robot buzzes. The README preview is
    re-encoded from the same render.
2026-10-22 Record a signal trace and single loop passes in the simulated hardware
2026-10-22 Show the firmware at signal level: trace, state machine, motors, and step mode
    Switches replace the speed and sound toggle buttons, and a test checks that
    every number the page copies from the firmware still matches it.
2026-10-22 Drop the glow on the switch knob and use the documented chip radius
2026-10-22 Note the signal view, the PDF viewer, and the switches in the changelog and README
2026-10-22 Apply the code and design review fixes to the signal view
    Switch states no longer survive a reload out of step with the page; a
    command sent in step mode shows as waiting; the trace keeps the current
    duty from the start, holds sonar readings with gaps for no echo, spreads
    encoder pulses within a physics step, and keeps tangerine for the current
    state and the stop line.
2026-10-22 Take the firmware signal view back out of the site
    The room, the remote, and its readout already show the real firmware at
    work; readers who want more read the thesis. The switches, the PDF.js
    viewer, and the first-person wording stay, and the test that the page's
    firmware numbers match the firmware now covers the room's status lines.
2026-10-24 Show diagram descriptions as captions, rename the section, add a sound button
    Each diagram's description is now its visible caption, and the image
    viewer shows the whole caption on several lines. The README describes
    the state machine below its diagram. For engineers becomes How it works,
    like the README. The project video gets a Play with sound button, and
    percentages drop the space before the sign.
2026-10-24 Note the search preload, captions, rename, and sound button in the changelog
2026-10-24 Put the sound button above the project video
2026-10-24 Apply the JS review fixes to search, preloading, and the sound button
    The film goes silent whenever it leaves the screen or the tab, also with
    reduced motion; restored results are versioned, re-ranked when they were
    keyword-only, and cleared if they fail to render; a failed preload no
    longer cancels a retry; preloading warms the viewer URL that links open,
    skips a video already loading, waits for a visible tab, and treats 3G
    like 2G; tables get column headers and a keyboard-reachable scroll area.
2026-10-24 Remove the unused pressed style for chips
    The 4x speed control is a switch now, so no chip carries aria-pressed.
2026-10-24 Add a back-to-top button to the project site
    It appears once the hero with the room has scrolled away, links to the top
    bar so it works without JavaScript, and leaves the tab order while hidden.
2026-10-25 Add the earlier firmware versions as docs/history
    The time-based first version, the per-wheel velocity PID, and the
    straight-line tuner that found the final gains and trim, kept as written
    with a timeline. Ruff skips them.
2026-10-25 Add the circuit board and 3D-printed part sources in hardware/
    The KiCad 9 board project, the SolidWorks part files for the chassis,
    lid, debris chamber, plate, supports, and mounts, and their drawings, with
    a guide. Vendor models and the assembly that uses them stay out.
2026-10-25 Fix the three board images in the hardware guide and test repo links
    The KiCad images live in docs/thesis/images/screenshots, not misc. A new
    test fails when a relative Markdown link, or a site or README link to this
    repository's files, points to a path that does not exist.
2026-10-25 Open the thesis at its first page from the Read the thesis button
