andrew-abdelmalak/smart-cleaning-robot/(notices)

Notices in the files:
README.md:
License: MIT
